F13LD3FF3CT/Dry-Cabinet/Cabinet_Ctrl BOM.xlsx

Quantity | Designator | Description | Manufacturer | Manufacturer Part Number
1 | C1 | 35V, 2700uF, Rubycon Electrolytic | Rubycon | 35TRV2700M18X21.5
12 | C2, C3, C4, C5, C6, C7, C8, C9, C10, C11, C12, C13 | Capacitor, Ceramic, X7R, 100nF, 100V, 0805 | Generic | 0805 0.1uF
4 | D1, D6, D12, D14 | Schottky Diode, 80V, SMA | Diodes Incorporated | B160-13-F
7 | D2, D3, D5, D7, D11, D13, D15 | 1206 Green LED 2V | Lite-On Inc. | LTST-C150KGKT
9 | D4, D8, D9, D10, D16, D17, D18, D19, D20 | SOT-23 Load Protect Diode Package | Generic | BAV99L
1 | F1 | Fuse, 32V, 15A, 1206 | Littelfuse | 0501015
4 | F2, F3, F4, F5 | Fuse, Resettable 200mA, 1206 | Bel Fuse Inc. | 0ZCJ0020FF2E
2 | J1, J2 | 3mm Microfit TH Header, 3-Pin | Molex, LLC | 0436500319
2 | J3, J4 | JST PH TH Header, 3-Pin | Generic
2 | J5, J6 | JST PH TH Header, 4-Pin | Generic
4 | K1, K2, K3, K4 | PANASONIC - ALQ112 - POWER RELAY, SPDT, 12VDC, 10A, THD | Panasonic | ALQ112
1 | LCD1 | I2C 16x2 LCD Module | DFR Robot | DFR0464
5 | P1, PJ1, PJ2, PJ3, PJ4 | XT30 Power Connector | Generic
4 | Q1, Q3, Q5, Q6 | BUK9Y21-40E - N-channel 40 V, 21 mΩ logic level MOSFET in LFPAK56 | Nexperia | BUK9Y21-40E,115
2 | Q2, Q4 | NPN 80V SOT-23 | ON Semiconductor | MMBTA06LT1G
9 | R1, R2, R4, R5, R7, R11, R12, R15, R20 | Resistor, 2K, 1/8W, 0805 | Generic | ERJ-6ENF2051V
4 | R3, R8, R14, R19 | Resistor, 68R, 1/8W, 0805 | Generic
12 | R6, R13, R16, R17, R18, R21, R22, R24, R25, R26, R27, R28 | Resistor, 10K, 1/8W, 0805 | Generic | ERJ-P06F1002V
2 | R9, R10 | Resistor, 49.9K, 1/8W, 0805 | Generic | ERJ-6ENF4992V
1 | R23 | Resistor, Footprint, 0805 | Not Used | Not Used
2 | RV1, RV2 | Res Cermet Trimmer 10K Ohm 10% 1/2W 1(Elec)/1(Mech)Turn 8.38mm (9.53 X 9.53 X 10.41mm) Pin Thru-Hole Tube | Bourns | 3386F-1-103TLF
5 | SW1, SW2, SW3, SW4, SW5 | 5mm SMT Tactile Pushbutton | E-Switch | TL3305AF160QG
5 | TB1, TB2, TB3, TB4, TB5 | 5mm 2-Position Spring Terminal Block | Phoenix Contact | 1715022
1 | U1 | Arduino Nano EVERY
1 | U2 | MC78M00 Series 500 mA 5 V Fixed Output Surface Mount LDO Regulator - TO-252 | ON Semiconductor | MC78M05ABDTRKG
1 | U3 | Humidity & Temperature Sensor ±2% RH ±0.3°C I2C DFN8 with Filter | Sensirion | SHT31-DIS-F2.5KS
