F13LD3FF3CT/Dry-Cabinet/Cabinet_Ctrl HW Design.pdf

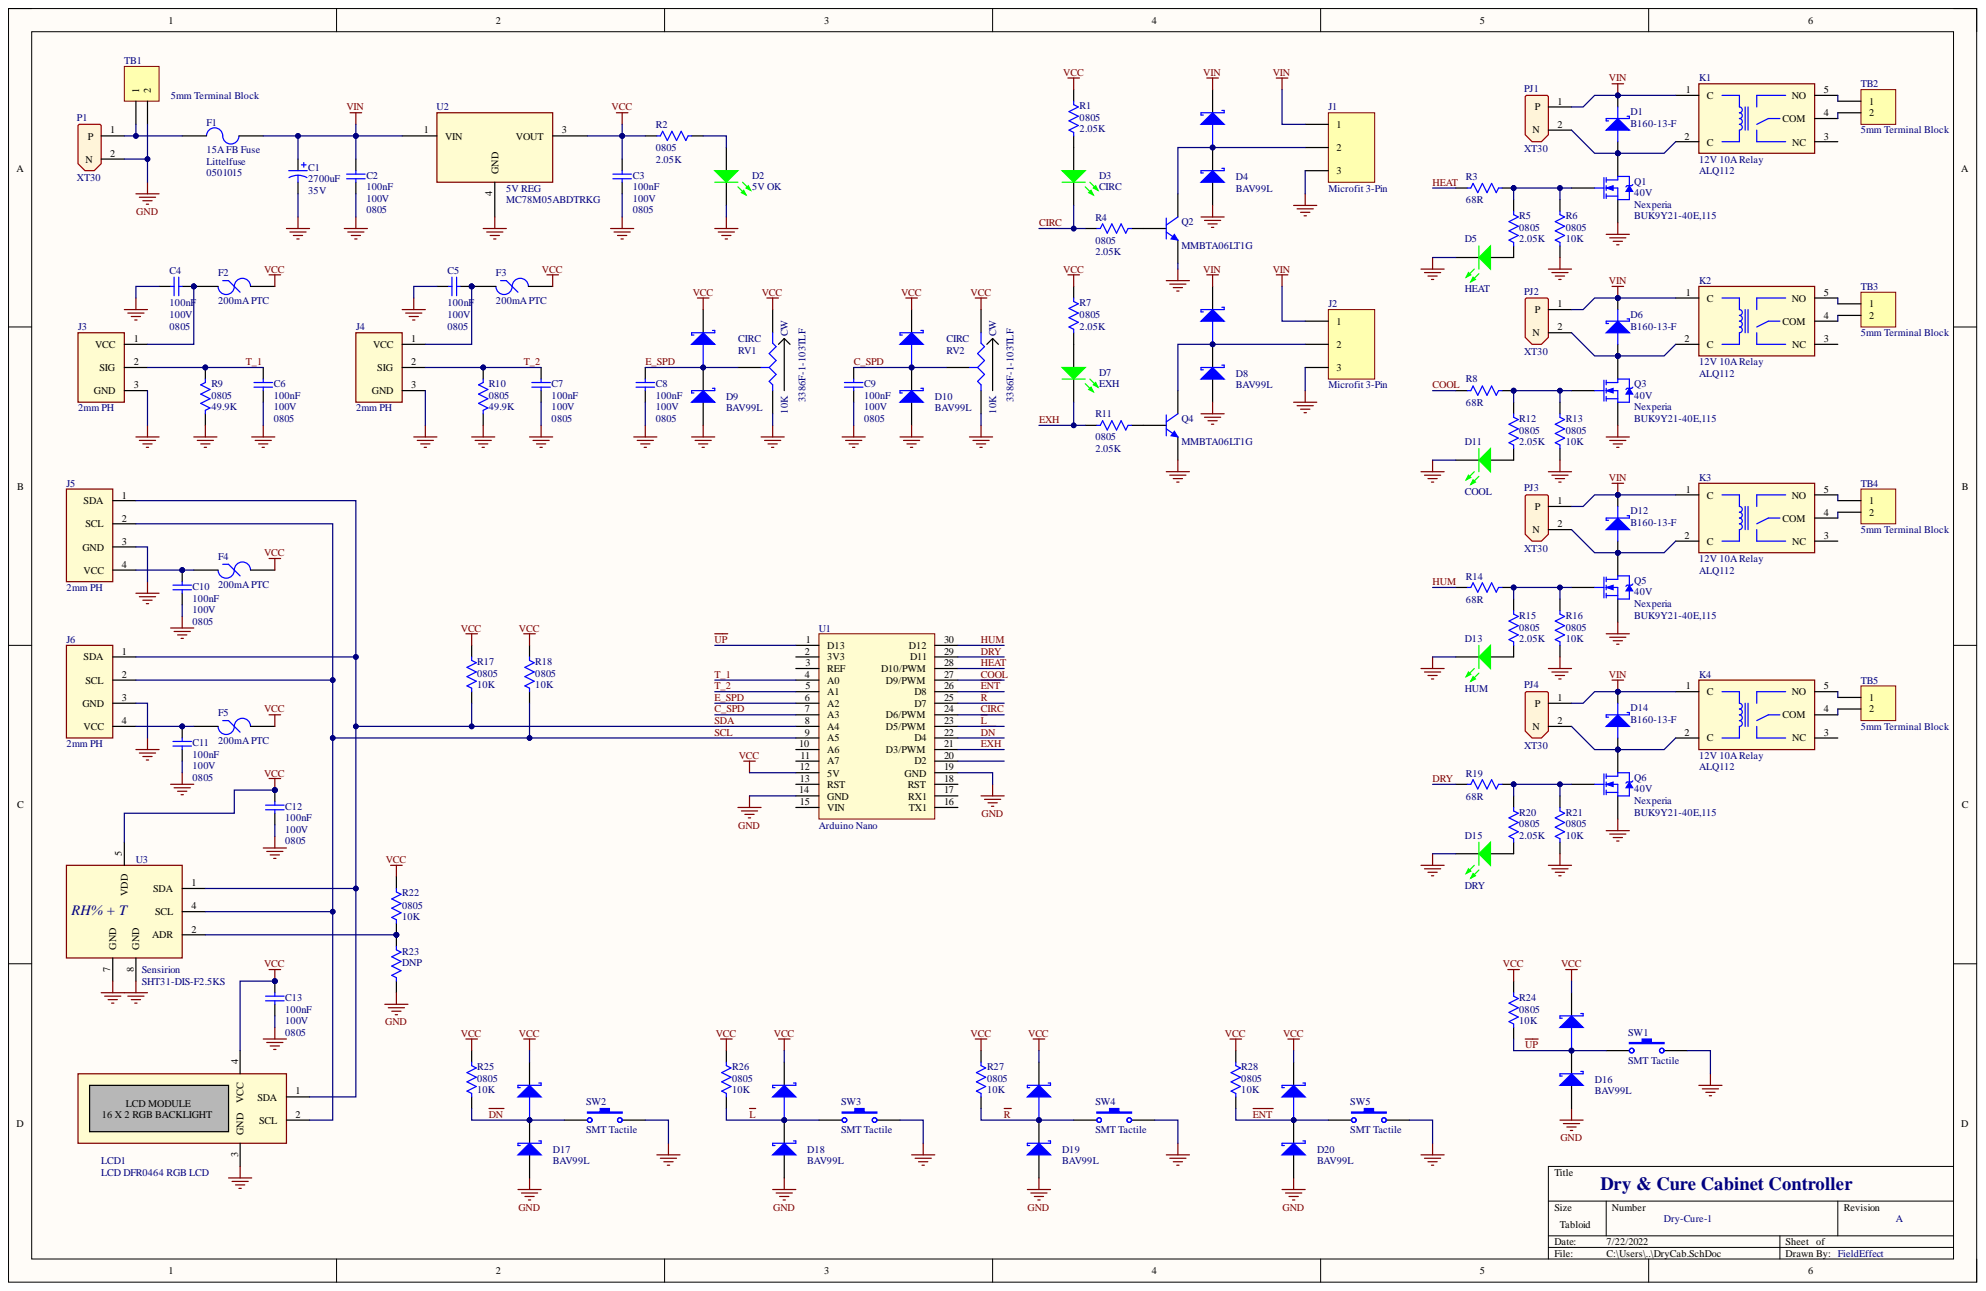
[picture p1: page 1]

D a t e : 7 / 2 2 / 2 0 2 2 | S h e e t o f
Fi l e : C : \ U s e r s \ . . \ D r y C a b . S c h D o c | D r a w n B y : Fi e l d E ffe c t

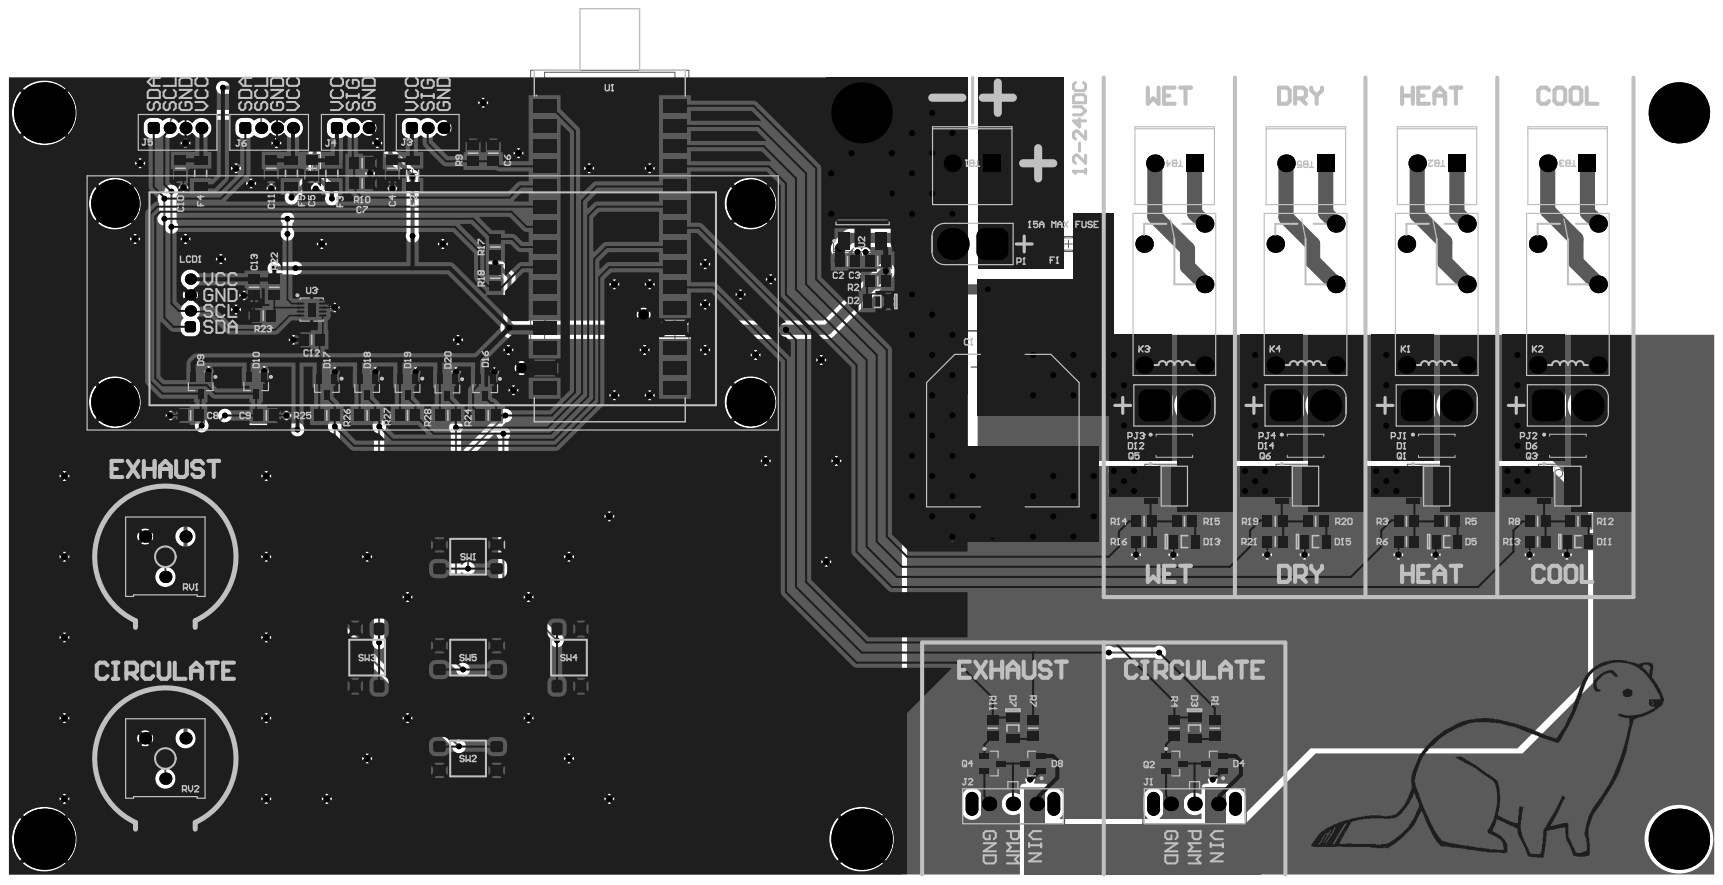
[picture p2: page 2]
